jamvanderloeff/RGB-to-component/RGB-to-component.kicad_pcb

## KiCad design RGB-to-component.kicad_pcb (2025-01-07)

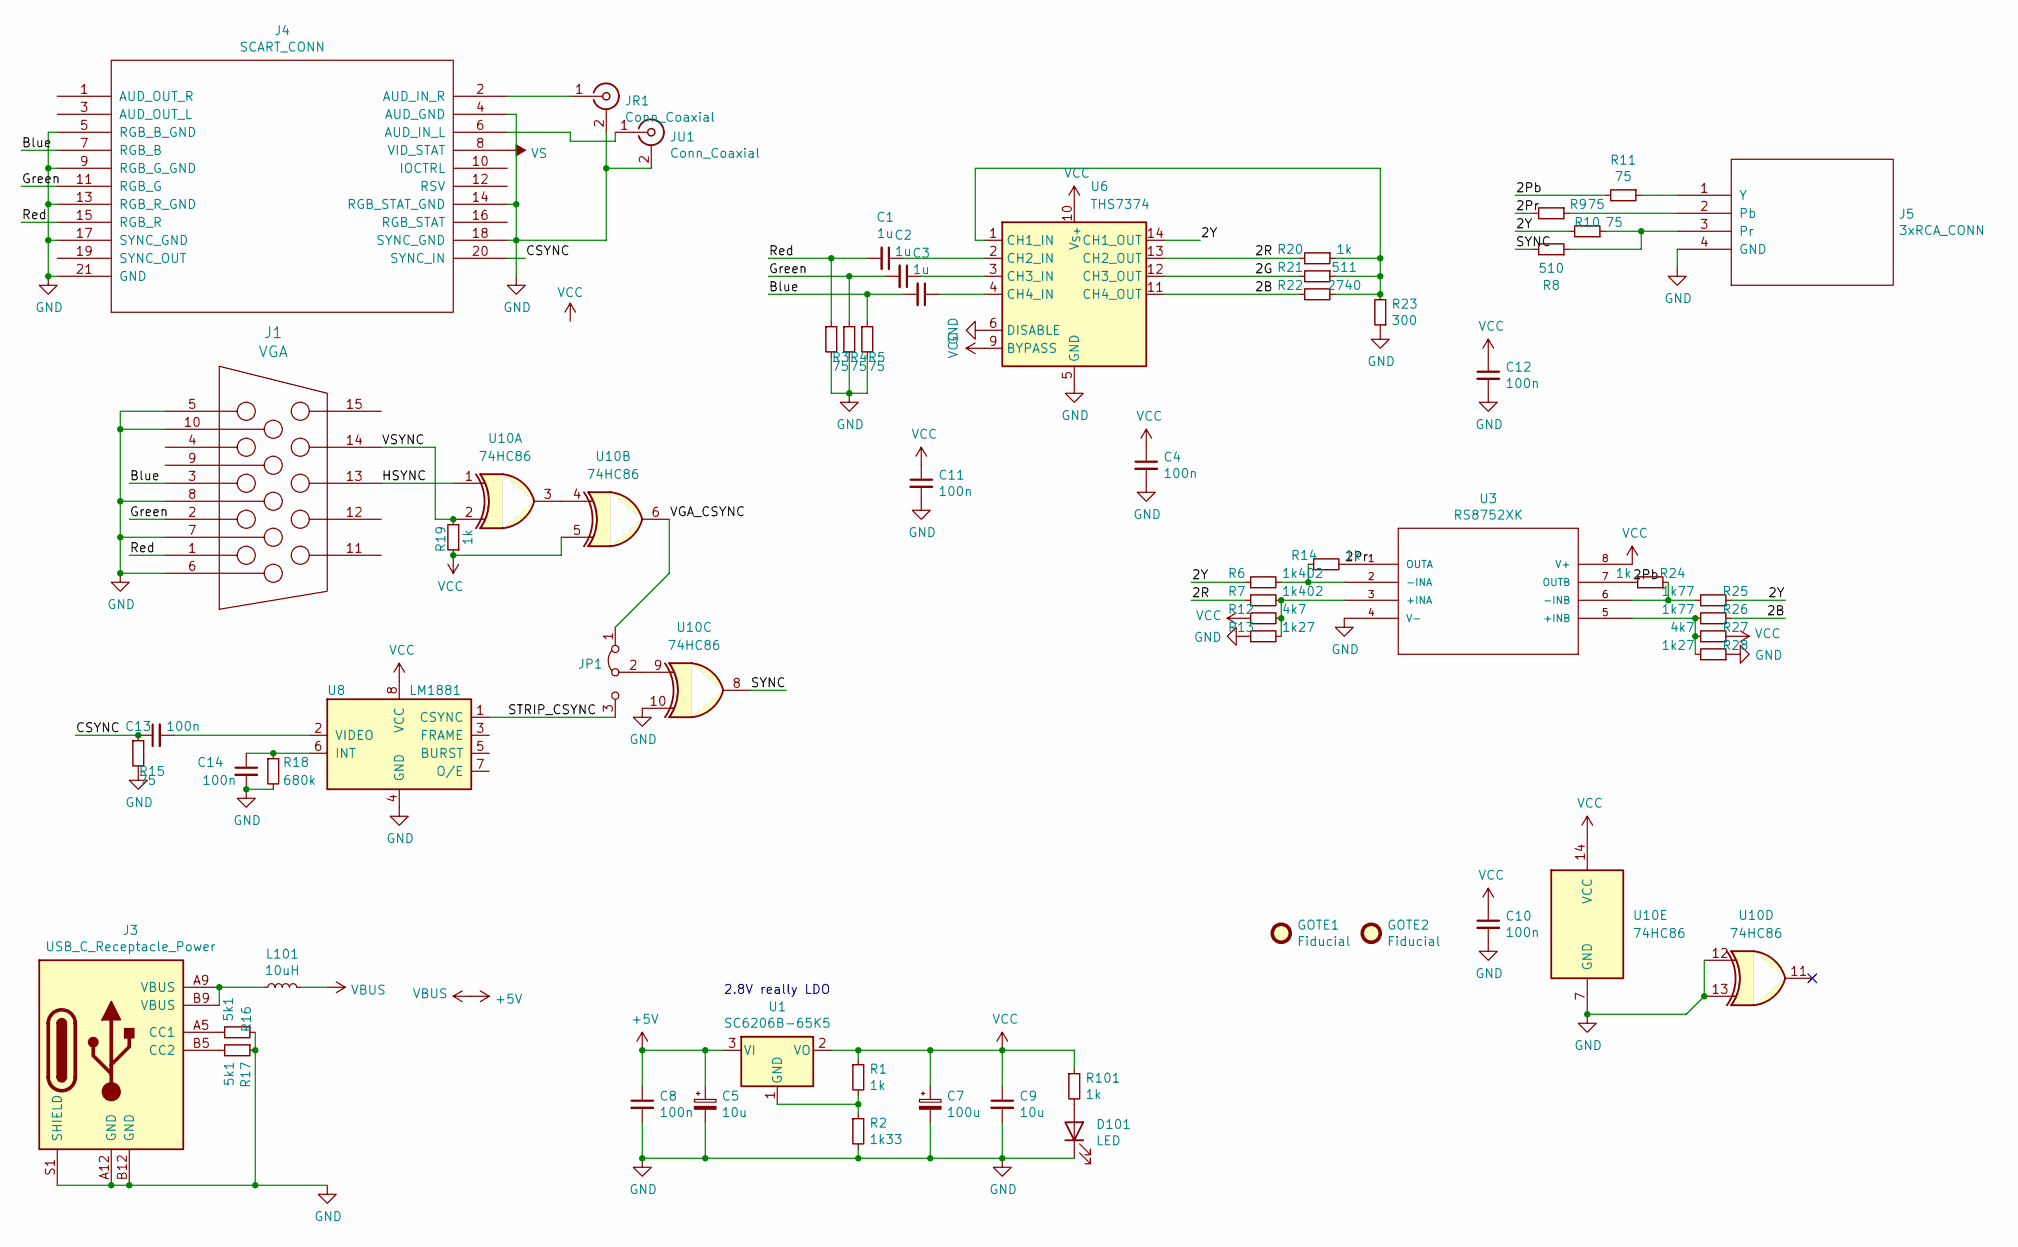
[picture p1: schematic RGB-to-component.kicad_sch, VGA/SCART to YPbPr converter]

Parts:
C1, C2, C3: 1u; C_0805_2012Metric_Pad1.15x1.40mm_HandSolder; LCSC C28323
C4, C8, C10, C11, C12, C13, C14: 100n; C_0805_2012Metric_Pad1.15x1.40mm_HandSolder; LCSC C14663
C5: 10u; CP_EIA-3216-18_Kemet-A_Pad1.58x1.35mm_HandSolder; LCSC C7171
C7: 100u; CP_EIA-3528-21_Kemet-B_Pad1.50x2.35mm_HandSolder; LCSC C16133
C9: 10u; C_0805_2012Metric_Pad1.15x1.40mm_HandSolder; LCSC C15850
D101: LED; LED_0805_2012Metric; LCSC C34499
GOTE1: Fiducial; uwuriel; LCSC NOT FITTED
GOTE2: Fiducial; borgar; LCSC NOT FITTED
J1: VGA; VGA_CONN; LCSC NOT FITTED
J3: USB_C_Receptacle_Power; USB_C_Receptacle_Generic_Power_Only; LCSC C283540
J4: SCART_CONN; LCSC NOT FITTED
J5: 3xRCA_CONN; 3xRCA_CONN_SINGLE; LCSC NOT FITTED
JP1: Jumper_3_Bridged12; SolderJumper-3_P1.3mm_Bridged12_Pad1.0x1.5mm; LCSC NOT FITTED
JR1: Conn_Coaxial; Cheapo_RCA_single_edge; LCSC NOT FITTED
JU1: Conn_Coaxial; Cheapo_RCA_single_edge; LCSC NOT FITTED
L101: 10uH; L_0805_2012Metric_Pad1.15x1.40mm_HandSolder; LCSC C1046
R1, R14, R19, R20, R24, R101: 1k; R_0805_2012Metric_Pad1.15x1.40mm_HandSolder; LCSC C17513
R2: 1k33; R_0805_2012Metric_Pad1.15x1.40mm_HandSolder; LCSC C17382
R3, R4, R5, R9, R10, R11, R15: 75; R_0805_2012Metric_Pad1.15x1.40mm_HandSolder; LCSC C17820
R6, R7: 1k402; R_0805_2012Metric_Pad1.15x1.40mm_HandSolder; LCSC C17388
R8: 510; R_0805_2012Metric_Pad1.15x1.40mm_HandSolder; LCSC C17734
R12, R27: 4k7; R_0805_2012Metric_Pad1.15x1.40mm_HandSolder; LCSC C17673
R13, R28: 1k27; R_0805_2012Metric_Pad1.15x1.40mm_HandSolder; LCSC C101451
R16, R17: 5k1; R_0805_2012Metric_Pad1.15x1.40mm_HandSolder; LCSC C27834
R18: 680k; R_0805_2012Metric_Pad1.15x1.40mm_HandSolder; LCSC C17797
R21: 511; R_0805_2012Metric_Pad1.15x1.40mm_HandSolder; LCSC C17736
R22: 2740; R_0805_2012Metric_Pad1.15x1.40mm_HandSolder; LCSC C322392
R23: 300; R_0805_2012Metric_Pad1.15x1.40mm_HandSolder; LCSC C17617
R25, R26: 1k77; R_0805_2012Metric_Pad1.15x1.40mm_HandSolder; LCSC C17397
U1: SC6206B-65K5; SOT-23; LCSC C130827
U3: RS8752XK; SOIC-8_3.9x4.9mm_P1.27mm; LCSC C236994
U6: THS7374; TSSOP-14_4.4x5mm_P0.65mm; LCSC C2652746
U8: LM1881; SOIC-8_3.9x4.9mm_P1.27mm; LCSC C518922
U10: 74HC86; TSSOP-14_4.4x5mm_P0.65mm

Connections:
+5V: C5.1, C8.1, L101.2, U1.3 (VI)
/2B: R22.2, R26.1, U6.11 (CH4_OUT)
/2G: R21.2, U6.12 (CH3_OUT)
/2Pb: R11.2, R24.2, U3.7 (OUTB)
/2Pr: R9.2, R14.2, U3.1 (OUTA)
/2R: R7.1, R20.2, U6.13 (CH2_OUT)
/2Y: R6.1, R10.2, R25.1, U6.14 (CH1_OUT)
/Blue: C3.2, J1.3 (BLUE), J4.7 (RGB_B), R5.1
/CSYNC: C13.1, J4.20 (SYNC_IN), R15.1
/Green: C2.2, J1.2 (GREEN), J4.11 (RGB_G), R4.1
/HSYNC: J1.13 (HSYNC), U10.1
/Red: C1.2, J1.1 (RED), J4.15 (RGB_R), R3.1
/STRIP_CSYNC: JP1.3 (B), U8.1 (CSYNC)
/SYNC: R8.2, U10.8
/VGA_CSYNC: JP1.1 (A), U10.6
/VSYNC: J1.14 (VSYNC), R19.2, U10.2
GND: C4.2, C5.2, C7.2, C8.2, C9.2, C10.2, C11.2, C12.2, C14.2, D101.1 (K), J1.5 (GND_HSYNC), J1.6 (RED_RTN), J1.7 (GREEN_RTN), J1.8 (BLUE_RTN), J1.10 (GND_VSYNC), J3.A12 (GND), J3.B12 (GND), J3.S1 (SHIELD), J4.4 (AUD_GND), J4.5 (RGB_B_GND), J4.9 (RGB_G_GND), J4.13 (RGB_R_GND), J4.14 (RGB_STAT_GND), J4.17 (SYNC_GND), J4.18 (SYNC_GND), J4.21 (GND), J5.4 (GND), JR1.2 (Ext), JU1.2 (Ext), R2.2, R3.2, R4.2, R5.2, R13.1, R15.2, R16.1, R17.1, R18.2, R23.1, R28.1, U3.4 (V-), U6.5 (GND), U6.6 (DISABLE), U8.4 (GND), U10.7 (GND), U10.10, U10.12, U10.13
unnamed: D101.2 (A), R101.2
unnamed: J3.A5 (CC1), R16.2
unnamed: J3.B5 (CC2), R17.2
unnamed: J3.A9 (VBUS), J3.B9 (VBUS), L101.1
unnamed: J4.6 (AUD_IN_L), JU1.1 (In)
unnamed: J4.2 (AUD_IN_R), JR1.1 (In)
unnamed: J5.2 (Pb), R9.1
unnamed: J5.3 (Pr), R8.1, R10.1
unnamed: J5.1 (Y), R11.1
unnamed: JP1.2 (C), U10.9
unnamed: R1.2, R2.1, U1.1 (GND)
unnamed: R7.2, R12.2, R13.2, U3.3 (+INA)
unnamed: R26.2, R27.2, R28.2, U3.5 (+INB)
unnamed: R6.2, R14.1, U3.2 (-INA)
unnamed: R24.1, R25.2, U3.6 (-INB)
unnamed: R20.1, R21.1, R22.1, R23.2, U6.1 (CH1_IN)
unnamed: C1.1, U6.2 (CH2_IN)
unnamed: C2.1, U6.3 (CH3_IN)
unnamed: C3.1, U6.4 (CH4_IN)
unnamed: C14.1, R18.1, U8.6 (INT)
unnamed: C13.2, U8.2 (VIDEO)
unnamed: U10.3, U10.4
VCC: C4.1, C7.1, C9.1, C10.1, C11.1, C12.1, R1.1, R12.1, R19.1, R27.1, R101.1, U1.2 (VO), U3.8 (V+), U6.9 (BYPASS), U6.10 (V_{S+}), U8.8 (VCC), U10.5, U10.14 (VCC)
VS: J4.8 (VID_STAT)

Notes on the sheet:
2.8V really LDO

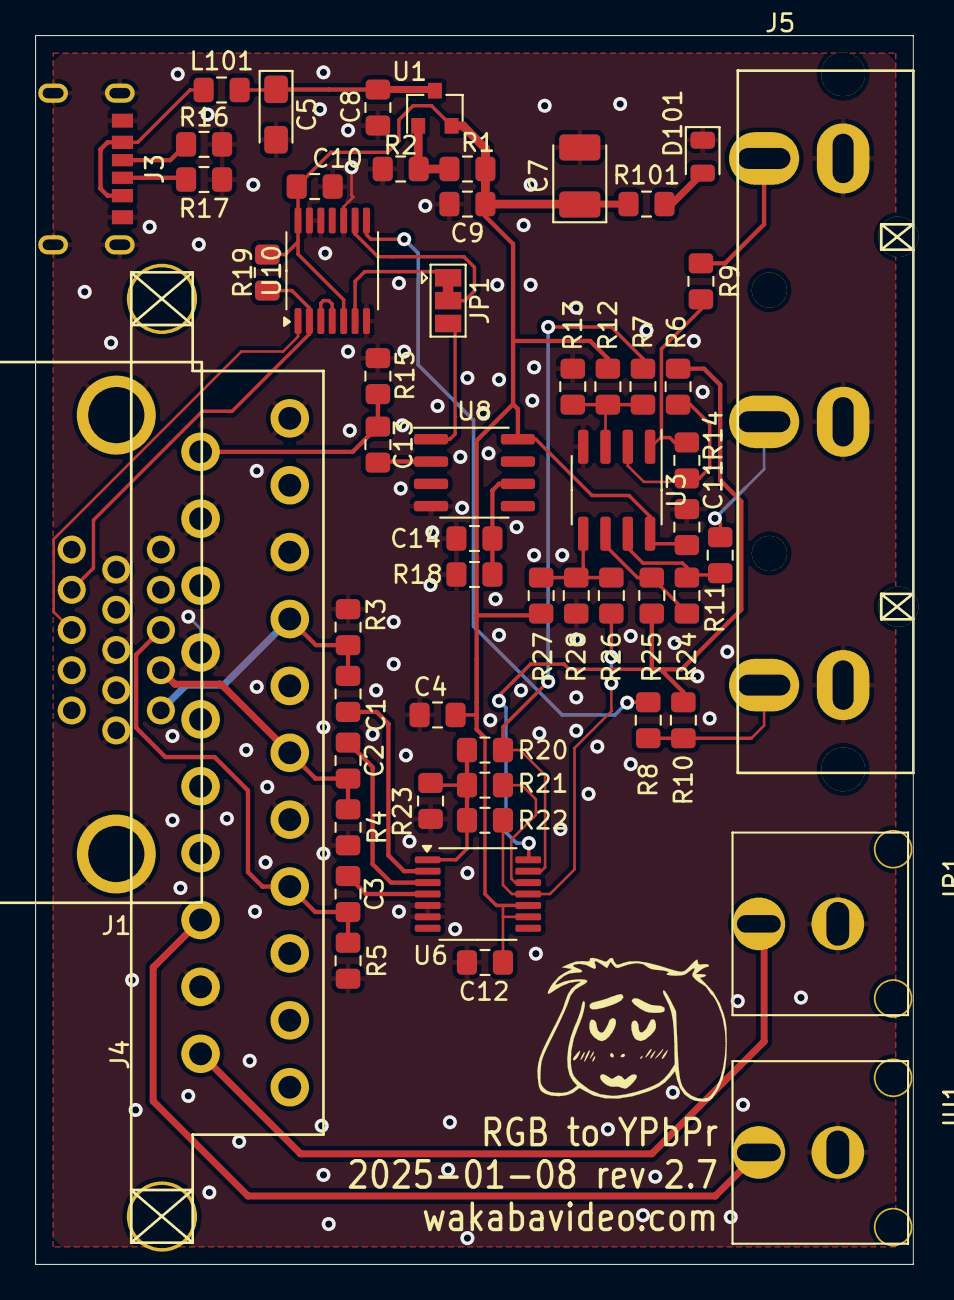
[picture p2: board RGB-to-component.kicad_pcb from above]

Board: 2 copper layers, 50.0 x 70.0 mm, 58 parts (1 on the bottom side), 40 nets.
