jamvanderloeff/RGB-to-component/RGB-to-component-covers.kicad_pcb

## KiCad design RGB-to-component-covers.kicad_pcb (2023-07-30)

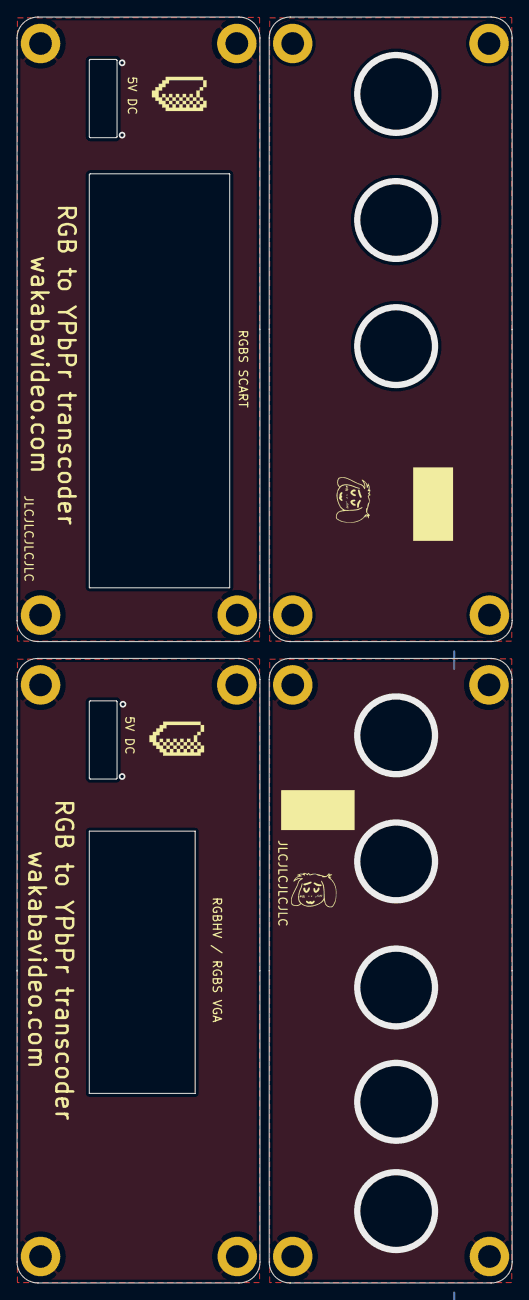
[picture p3: board RGB-to-component-covers.kicad_pcb from above]

Board: 2 copper layers, 58.9 x 150.6 mm, 16 parts (0 on the bottom side), 3 nets.

Parts:
H1, H3, H4, H4#2, H5, H7, H8, H8#2, H9, H11, H12, H12#2, H13, H15, H16, H16#2: MountingHole_Pad; MountingHole_2.7mm_M2.5_DIN965_Pad

Connections:
/GND1: H1.1, H5.1, H9.1, H13.1
/GND3: H3.1, H7.1, H11.1, H15.1
/GND4: H4.1, H8.1, H12.1, H16.1
