jamvanderloeff/RGB-to-component/(commit log)

2020-04-04 updated gerber
    [RGB-to-component-B_Cu.gbr, RGB-to-component-B_Mask.gbr, RGB-to-component-B_Paste.gbr, RGB-to-component-B_SilkS.gbr, RGB-to-component-Edge_Cuts.gbr, RGB-to-component-F_Cu.gbr, RGB-to-component-F_Mask.gbr, RGB-to-component-F_Paste.gbr]
2020-06-11 reusing video amp, ferrite, power led, updated jlc files
    [RGB-to-component-B_Cu.gbr, RGB-to-component-B_Mask.gbr, RGB-to-component-B_Paste.gbr, RGB-to-component-B_SilkS.gbr, RGB-to-component-Edge_Cuts.gbr, RGB-to-component-F_Cu.gbr, RGB-to-component-F_Mask.gbr, RGB-to-component-F_Paste.gbr]
2020-06-11 starting panelise
    [RGB-to-component-panel.kicad_pcb, RGB-to-component.kicad_pcb]
2020-06-26 fixed resistor
    [RGB-to-component-panel.kicad_pcb, RGB-to-component.kicad_pcb, RGB-to-component.sch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]
2020-11-01 changed RCA jacks to single centre pin style, AHCT gates for VGA sync
    [RGB-to-component-B_Cu.gbr, RGB-to-component-B_Mask.gbr, RGB-to-component-B_Paste.gbr, RGB-to-component-B_SilkS.gbr, RGB-to-component-Edge_Cuts.gbr, RGB-to-component-F_Cu.gbr, RGB-to-component-F_Mask.gbr, RGB-to-component-F_Paste.gbr]
2021-05-09 swapped opamp for SOIC package
    [RGB-to-component-B_Cu.gbr, RGB-to-component-B_Mask.gbr, RGB-to-component-B_Paste.gbr, RGB-to-component-B_SilkS.gbr, RGB-to-component-Edge_Cuts.gbr, RGB-to-component-F_Cu.gbr, RGB-to-component-F_Mask.gbr, RGB-to-component-F_Paste.gbr]
2021-09-02 add single panel assembly file
    [RGB-to-component-NPTH.drl, RGB-to-component-PTH.drl, RGB-to-component-top-pos.csv]
2021-09-23 add the cover plates
    [RGB-to-component-covers-B_Cu.gbr, RGB-to-component-covers-B_Mask.gbr, RGB-to-component-covers-B_SilkS.gbr, RGB-to-component-covers-Edge_Cuts.gbr, RGB-to-component-covers-F_Cu.gbr, RGB-to-component-covers-F_Mask.gbr, RGB-to-component-covers-F_SilkS.gbr, RGB-to-component-covers-NPTH.drl]
2021-11-27 covers gerb for vga/shart->component
    [RGB-to-component-covers-B_Cu.gbr, RGB-to-component-covers-B_Mask.gbr, RGB-to-component-covers-B_SilkS.gbr, RGB-to-component-covers-Edge_Cuts.gbr, RGB-to-component-covers-F_Cu.gbr, RGB-to-component-covers-F_Mask.gbr, RGB-to-component-covers-F_SilkS.gbr, RGB-to-component-covers-NPTH.drl]
2022-08-06 converting to kicad 6
    [RGB-to-component.kicad_pcb, RGB-to-component.kicad_sch]
2022-09-09 return to THS7374 (temporary single board only)
    [RGB-to-component.kicad_pcb, RGB-to-component.kicad_sch]
2022-09-09 updates single gerbs with THS7374
    [RGB-to-component-B_Cu.gbr, RGB-to-component-B_Mask.gbr, RGB-to-component-B_Paste.gbr, RGB-to-component-B_Silkscreen.gbr, RGB-to-component-Edge_Cuts.gbr, RGB-to-component-F_Cu.gbr, RGB-to-component-F_Mask.gbr, RGB-to-component-F_Paste.gbr]
2022-09-16 gerbs update
    [RGB-to-component-B_Cu.gbr, RGB-to-component-B_Mask.gbr, RGB-to-component-B_Paste.gbr, RGB-to-component-B_Silkscreen.gbr, RGB-to-component-Edge_Cuts.gbr, RGB-to-component-F_Cu.gbr, RGB-to-component-F_Mask.gbr, RGB-to-component-F_Paste.gbr]
2022-11-10 swapping video amps again to TPF141 for JLC availability
    [RGB-to-component-B_Cu.gbr, RGB-to-component-B_Mask.gbr, RGB-to-component-B_Paste.gbr, RGB-to-component-B_SilkS.gbr, RGB-to-component-B_Silkscreen.gbr, RGB-to-component-Edge_Cuts.gbr, RGB-to-component-F_Cu.gbr, RGB-to-component-F_Mask.gbr]
2023-01-06 covers updated
    [RGB-to-component-covers-B_Cu.gbr, RGB-to-component-covers-B_Mask.gbr, RGB-to-component-covers-B_Silkscreen.gbr, RGB-to-component-covers-Edge_Cuts.gbr, RGB-to-component-covers-F_Cu.gbr, RGB-to-component-covers-F_Mask.gbr, RGB-to-component-covers-F_Silkscreen.gbr, RGB-to-component-covers-NPTH.drl]
2023-07-29 updated to kicad 7
    [RGB-to-component.kicad_sch]
2023-07-30 folder cleanup
    [RGB-to-component-B_Cu.gbr, RGB-to-component-B_Mask.gbr, RGB-to-component-B_Paste.gbr, RGB-to-component-B_Silkscreen.gbr, RGB-to-component-Edge_Cuts.gbr, RGB-to-component-F_Cu.gbr, RGB-to-component-F_Mask.gbr, RGB-to-component-F_Paste.gbr]
2023-12-26 kicad update, oscillator footprint replaced
    [RGB-to-component.kicad_pcb, RGB-to-component.kicad_sch]
2024-01-10 75 ohm removed from hsync, only terminates scart's csync
    [RGB-to-component.kicad_pcb, RGB-to-component.kicad_sch, bom.csv, designators.csv, positions.csv]
2024-05-23 buffer csync stripper, logic moved to single chip
    [RGB-to-component.kicad_pcb]
2024-05-23 prod files
    [bom.csv, designators.csv, positions.csv]
2024-05-23 remember to save the schematic too
    [RGB-to-component.kicad_sch]
2025-01-07 change back to THS7374
    [RGB-to-component.kicad_pcb, RGB-to-component.kicad_sch]
2025-01-07 swap to THS7374, updated parts
    [RGB-to-component.kicad_pcb, RGB-to-component.kicad_sch, bom.csv, designators.csv, positions.csv]
